iBehave-CADRE/DrosoMenuPro/README.md

# DrosoMenuPro

A stimulus delivery device for head-fixed flies. Can be remotely triggered via digital and analog inputs (any DAQ) or via serial communication (MATLAB, Python, Bonsai etc.).

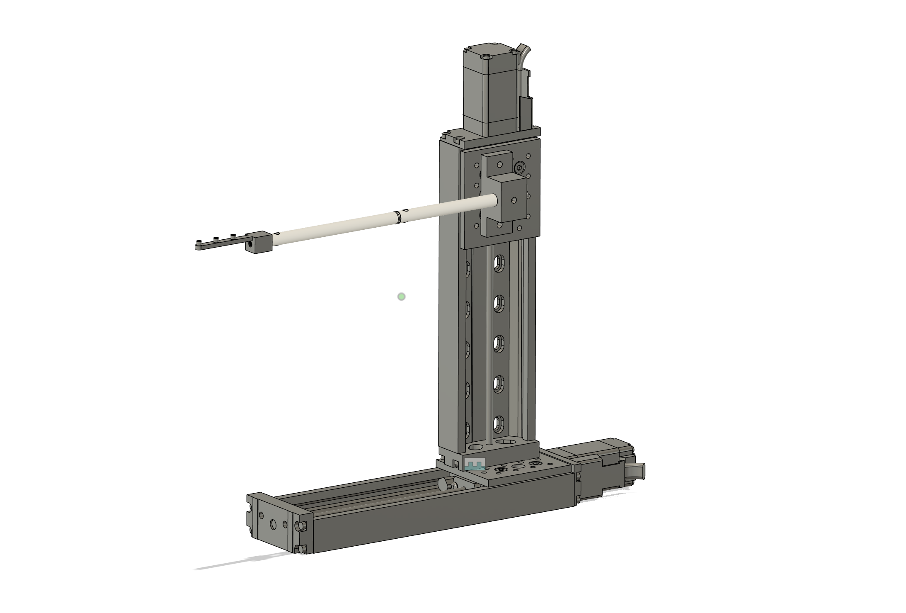
[picture p1: images/FeedingDevice.png]
Feeding Device


**Figure 1:** DrosoMenuPro Device for stimulus delivery to head-fixed flies.

## Electronics Scheme

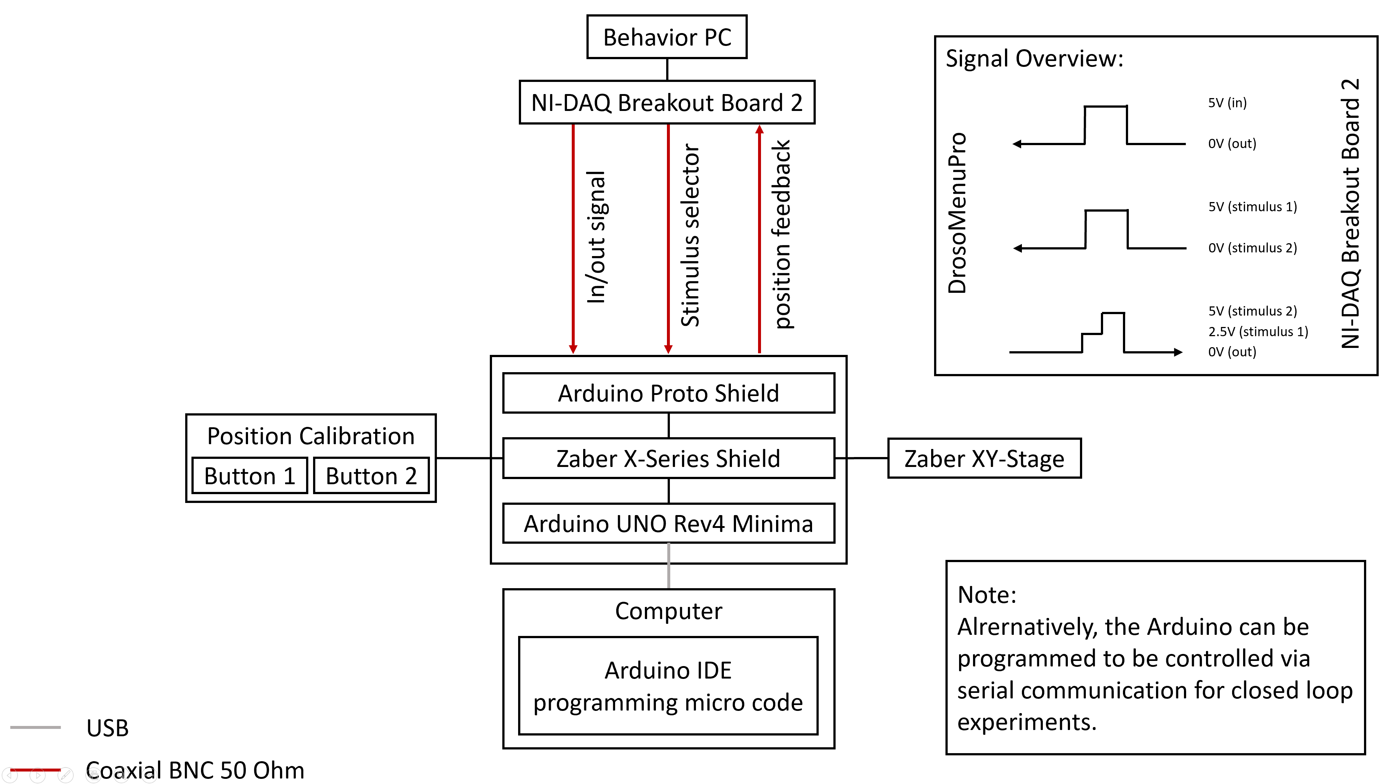
[picture p2: images/schematic.png]


**Figure 2:** Schematic illustration of how the DrosoMenuPro can be integrated into existing behavior setups.

## Shopping List

| Item | Order Nr. | Link to Supplier | Amount | Price | Notes |
| --- | --- | --- | --- | --- | --- |
| Zaber X-Series Shield for Arduino | X-AS01 | [Link](https://www.zaber.com/products/accessories/X-AS01) | 1-2 | 129.- USD | One extra would be good in case of damage (has happened before) |
| Zaber Data Cable | X-DC02 | [Link](https://www.zaber.com/products/accessories/X-DC02) | 1 | 15.- USD | Connecting Shield to Stage |
| Zaber XY-Stage (2x X-LSM100B-E03) | Configurator | [Link](https://www.zaber.com/products/xy-xyz-motorized-stages/LSM-XY-XYZ/configurator/XY-LSM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) | 1 | 5905.- USD | XY-Axis Travel 100mm, Lead Screw Pitch B (medium), Built-in encoders true, integrated controller |
| Thorlabs Mini-Series Optical Post | MS3R/M | [Link](https://www.thorlabs.com/item/MS3R_M) | 2 | 9.02 EUR | For holding stimuli |
| Arduino Uno R4 minima | ABX00080 | [Link](https://www.conrad.de/de/p/arduino-abx00080-board-uno-rev4-minima-2865738.html?insert=VQ) | 1 | 21,42 EUR |  |
| BNC Connectors | 1570975 - VQ | [Link](https://www.conrad.de/de/p/tru-components-lt-bnc-f-bnc-steckverbinder-buchse-gerade-50-1-st-1570975.html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) | 5 | 3,49 EUR | For initial prototype without case |
| USB Cable | 1460360 - VQ | [Link](https://www.conrad.de/de/p/renkforce-usb-kabel-usb-3-2-gen1-usb-a-stecker-usb-c-stecker-1-00-m-schwarz-vergoldete-steckkontakte-rf-4381080-1460360.html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) | 1 | 7,49 EUR | For programming Arduino |
| Arduino Proto Shield | 1969858 - VQ | [Link](https://www.conrad.de/de/p/arduino-proto-shield-entwicklungsboard-1969858.html?insert=VQ) | 1 | 14,59 EUR | For soldering cables etc. |
| Jumper Cables Kit | 2481791 - VQ | [Link](https://www.conrad.de/de/p/tru-components-jumper-kabel-arduino-1x-drahtbruecken-buchse-1x-drahtbruecken-buchse-bunt-2481791.html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) | 1 | 4,79 EUR |  |
| Jumper Cables | 2299844 - VQ | [Link](https://www.conrad.de/de/p/renkforce-jkmf403-jumper-kabel-arduino-banana-pi-raspberry-pi-40x-drahtbruecken-stecker-40x-drahtbruecken-buchse-30-2299844.html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) | 1 | 3,29 EUR |  |
| BNC Cables | N.A. | N.A. | N.A. | N.A. | If not available order more |

### Custom Designed Parts
| Item | Link to File | Material | Amount | Price | Alternative | Notes |
| --- | --- | --- | --- | --- | --- | --- |
| BIT-Boy | [Link]() |  |  |  |  | For Debugging (should be in Lab already) |
| Optical Post Bracket | [Link]() |  |  |  |  |  |
| Stimulus Holder | [Link]() |  |  |  |  |  |

## Links and Ressources

[Zaber Arduino Shield Generic Commands Protocol Manual](https://www.zaber.com/protocol-manual)

[Zaber Arduino Shield ASCII Library Documentation, Examples and Getting Started](https://gitlab.com/zaber-core-libs/zaber-ascii-for-arduino)

[Zaber Arduino Shield Hardware Overview](https://www.zaber.com/products/accessories/X-AS01/overview)
