iBehave-CADRE/DrosoMenuPro/DrosoMenuPro.pptx

Behavior PC

NI-DAQ Breakout Board 2

Signal Overview:

5V (in)

DrosoMenuPro

0V (out)

5V (stimulus 1)

NI-DAQ Breakout Board 2

In/out signal

Stimulus selector

position feedback

0V (stimulus 2)

5V (stimulus 2)

2.5V (stimulus 1)

Arduino Proto Shield

Zaber X-Series Shield

Arduino UNO Rev4 Minima

Zaber XY-Stage

Computer

Arduino IDE
programming micro code

0V (out)

Position Calibration

Button 1

Button 2

Note:
Alrernatively, the Arduino can be programmed to be controlled via serial communication for closed loop experiments.

USB

Coaxial BNC 50 Ohm
